luckymuniza/RC_light_control_MFC-01/HW_MFC01/pinout.txt

  J5  J6  J4  J3  J1   J2 
1 3V3 3V3 3V3 KJ4 SPI+ GND
2 SPI SPI 5V  KJ5 SPI- +5V
3 SML SPI SML KJ6 SML+ SBUS 
4 SMR SML SMR KJ7 SML-
5 ZAD SMR MAJ     SMR+
6 BOC ZAD PSV     SMR-
7 MAJ ZAD MAJs    ZAD+
8     SPZ         ZAD-
