luckymuniza/RC_light_control_MFC-01/HW_MFC01/HW_MFC01.kicad_pcb

## KiCad design HW_MFC01/HW_MFC01.kicad_pcb (2026-08-25)

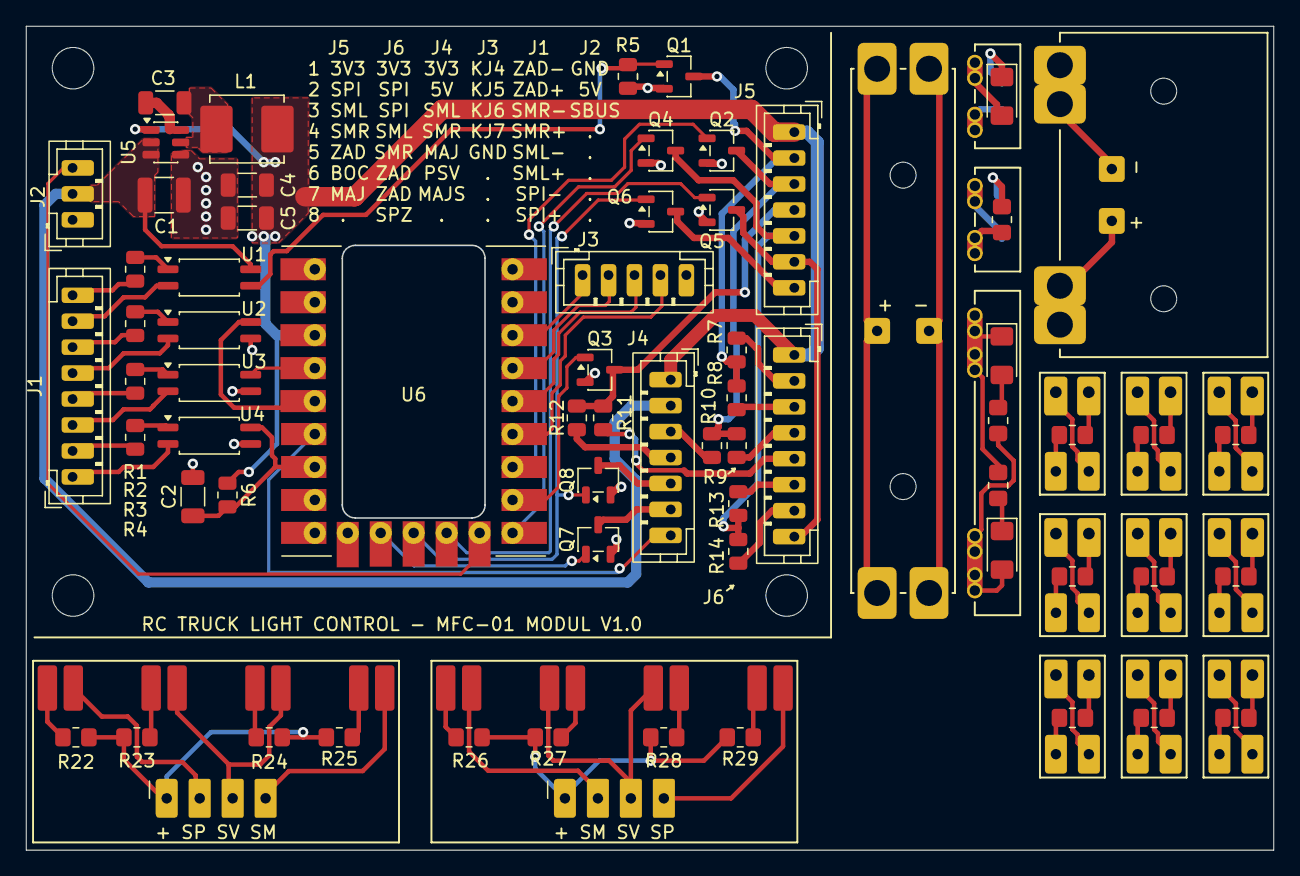
[picture p1: board HW_MFC01.kicad_pcb from above]

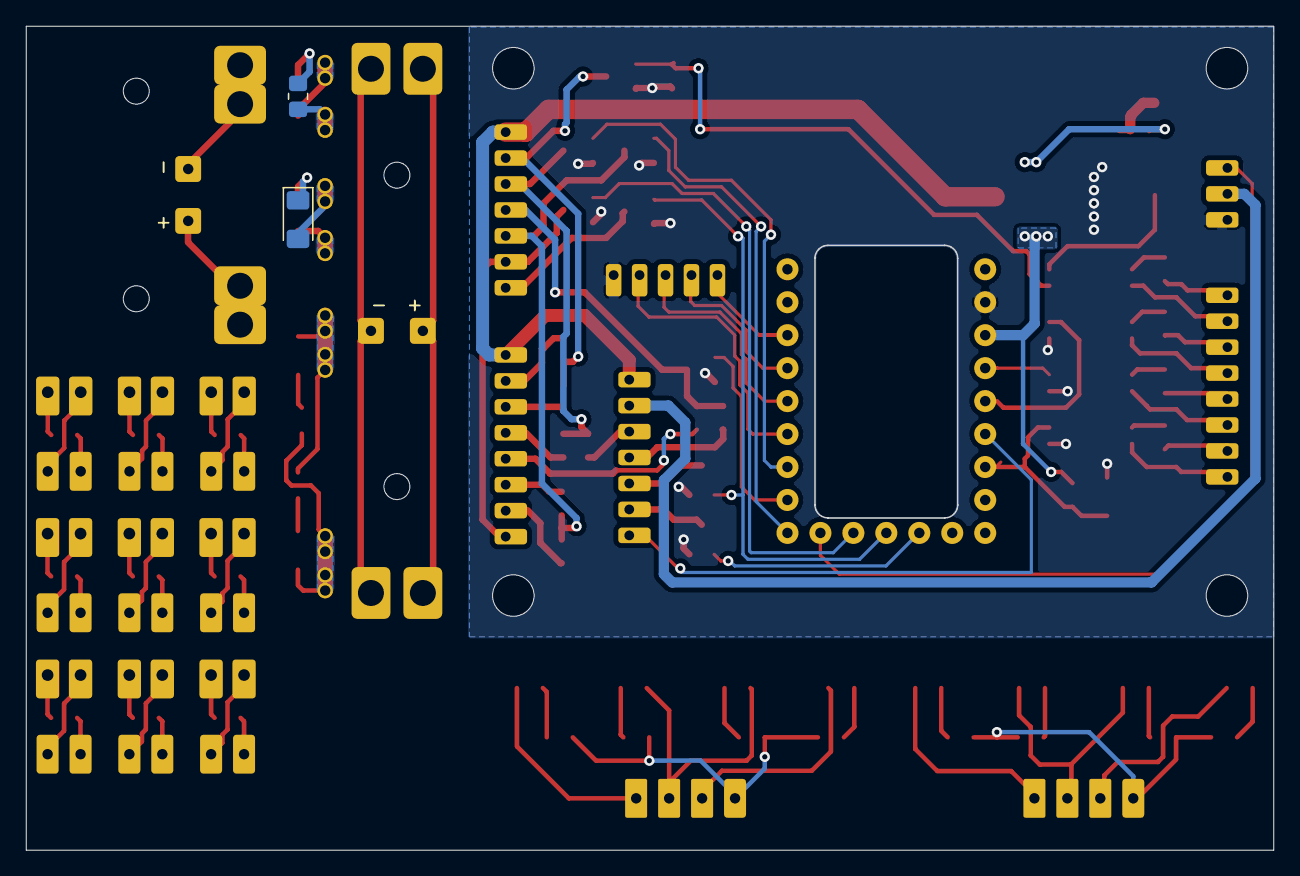
[picture p2: board HW_MFC01.kicad_pcb from below]

Board: 2 copper layers, 96.1 x 63.5 mm, 96 parts (2 on the bottom side), 88 nets.

Parts:
C1: 10u/50V; C_1210_3225Metric
C2, C3: 100n; C_1206_3216Metric
C4, C5: 22u/16V; C_1206_3216Metric
D1, D2, D3, D4: LED; LED_1206_3216Metric_Pad1.42x1.75mm_HandSolder
D5, D5#2, D5#3, D6, D6#2, D6#3, D7, D7#2, D7#3: LED; LED_D3.0mm_mod
H1, H2, H3, H4: MountingHole; MountingHole_3.2mm_M3
J1, J6: Conn_01x08; JST_PH_B8B-PH-K_1x08_P2.00mm_Vertical_Bigpads
J2: JST_PH_B3B-PH-K_1x03_P2.00mm_Vertical_Bigpads
J3: Conn_01x05; JST_PH_B5B-PH-K_1x05_P2.00mm_Vertical_Bigpads
J4, J5: Conn_01x07; JST_PH_B7B-PH-K_1x07_P2.00mm_Vertical_Bigpads
J7: Conn_01x06_Pin; REAR_SPZ1
J8, J9: Conn_01x02_Pin; REAR_SPZ2
J10: Conn_01x04_Pin; REAR2_SPZ1
J11: Conn_01x02_Pin; REAR2_SPZ2
J12, J12#2, J12#3, J13, J13#2, J13#3, J14, J14#2, J14#3: Conn_01x02_Pin; PinSocket_1x02_P2.54mm_modpads
J15, J18: Conn_01x08; rearlight_PCB
J19, J20: Conn_01x04_Pin; PinSocket_1x04_P2.54mm_modpads
L1: 6.8uH; L_Panasonic_PCC-M0530M
Q1, Q2, Q3, Q4, Q5, Q6, Q7, Q8: IRLML0030; SOT-23-3
R1, R2, R3, R4, R5, R6, R7, R8, R9, R10, R11, R12, R13, R14: 10k; R_0805_2012Metric
R15, R16, R17, R18, R19, R19#2, R19#3, R20, R20#2, R20#3, R21, R21#2, R21#3, R22, R23, R24, R25, R26, R27, R28, R29: R; R_0805_2012Metric_Pad1.20x1.40mm_HandSolder
U1, U2, U3, U4: EL3H7; SOP-4_4.4x2.6mm_P1.27mm
U5: AP63203WU; TSOT-23-6
U6: RP2040-Zero; RP2040 Zero undercutted

Connections:
+3.3V: C4.1, C5.1, J4.1, J5.1, J6.1, L1.2, R6.1, U5.1 (FB), U6.3 (3V3)
+5V: C1.1, J2.2, J4.2, U1.4, U5.2 (EN), U5.3 (IN)
/BEACON F: J4.5, Q8.3 (D)
/BEACON_OUT: Q6.1 (G), Q8.1 (G), U6.21 (GP11)
/FRONT_BEACON_PWM: J4.7, U6.6 (GP27)
/HEAD LIGHTS: J4.6, Q7.3 (D)
/HEAD_LIGHTS: Q7.1 (G), U6.20 (GP12)
/J4: J3.1, U6.12 (GP2)
/J5: J3.2, U6.13 (GP3)
/J6: J3.3, U6.14 (GP4)
/J7: J3.4, U6.15 (GP5)
/REAR L: J6.6, R13.1
/REAR R: J6.7, R14.1
/REAR+: J1.2, R4.1
/REAR-: J1.1, U4.2
/REAR_LIGHT_IN: C2.1, R6.2, U4.4, U6.7 (GP26)
/REAR_PWM_OUT: Q4.1 (G), U6.18 (GP8)
/REV+: J1.8, R1.1
/REV-: J1.7, U1.2
/REVERSE L: J6.2, R7.1
/REVERSE R: J6.3, R8.1
/REVERSE_LIGHTS_IN: Q1.1 (G), R5.2, U1.3
/SBUS_IN: J2.3, U6.23 (GP9)
/SIDE_LIGHTS: Q5.1 (G), U6.22 (GP10)
/TRA BEACON: J5.7, Q6.3 (D)
/TRA REAR: J5.5, Q4.3 (D), R13.2, R14.2
/TRA REVERSE: J5.2, Q1.3 (D), R7.2, R8.2
/TRA SIDE LIGHTS/SPZ: J5.6, J6.8, Q5.3 (D)
/TRA TURN L: J5.3, Q2.3 (D), R9.2, R10.2
/TRA TURN R: J5.4, Q3.3 (D), R11.2, R12.2
/TURN F L: J4.3, R10.1
/TURN F R: J4.4, R12.1
/TURN L: J6.4, R9.1
/TURN R: J6.5, R11.1
/TURNL+: J1.6, R2.1
/TURNL-: J1.5, U2.2
/TURNR+: J1.4, R3.1
/TURNR-: J1.3, U3.2
/TURN_L_IN: U2.4, U6.5 (GP28)
/TURN_L_PWM_OUT: Q2.1 (G), U6.16 (GP6)
/TURN_R_IN: U3.4, U6.4 (GP29)
/TURN_R_PWM_OUT: Q3.1 (G), U6.17 (GP7)
GND: C1.2, C2.2, C4.2, C5.2, J2.1, J3.5, Q1.2 (S), Q2.2 (S), Q3.2 (S), Q4.2 (S), Q5.2 (S), Q6.2 (S), Q7.2 (S), Q8.2 (S), R5.1, U2.3, U3.3, U4.3, U5.4 (GND), U6.2 (GND)
unnamed: D1.2 (A), J8.1
unnamed: D1.1 (K), R15.2
unnamed: D2.2 (A), J9.1
unnamed: D2.1 (K), R16.2
unnamed: D3.2 (A), R17.2
unnamed: D3.1 (K), J11.1, R18.1
unnamed: D4.2 (A), J11.2, R17.1
unnamed: D4.1 (K), R18.2
unnamed: D5.2 (A), D5#2.2 (A), D5#3.2 (A), J12.1, J12#2.1, J12#3.1
unnamed: D5.1 (K), D5#2.1 (K), D5#3.1 (K), R19.2, R19#2.2, R19#3.2
unnamed: D6.2 (A), D6#2.2 (A), D6#3.2 (A), J13.1, J13#2.1, J13#3.1
unnamed: D6.1 (K), D6#2.1 (K), D6#3.1 (K), R20.2, R20#2.2, R20#3.2
unnamed: D7.2 (A), D7#2.2 (A), D7#3.2 (A), J14.1, J14#2.1, J14#3.1
unnamed: D7.1 (K), D7#2.1 (K), D7#3.1 (K), R21.2, R21#2.2, R21#3.2
unnamed: J7.1, J7.3, J7.5
unnamed: J7.2, J7.4, J7.6
unnamed: J8.2, R15.1
unnamed: J9.2, R16.1
unnamed: J10.1, J10.3
unnamed: J10.2, J10.4
unnamed: J12.2, J12#2.2, J12#3.2, R19.1, R19#2.1, R19#3.1
unnamed: J13.2, J13#2.2, J13#3.2, R20.1, R20#2.1, R20#3.1
unnamed: J14.2, J14#2.2, J14#3.2, R21.1, R21#2.1, R21#3.1
unnamed: J15.1, R22.1
unnamed: J15.2, J19.2
unnamed: J15.3, R23.1
unnamed: J15.4, J15.6, J19.3
unnamed: J15.5, R24.1
unnamed: J15.7, R25.1
unnamed: J15.8, J19.4
unnamed: J18.1, R26.1
unnamed: J18.2, J20.2
unnamed: J18.3, J18.5, J20.3
unnamed: J18.4, R27.1
unnamed: J18.6, R28.1
unnamed: J18.7, R29.1
unnamed: J18.8, J20.4
unnamed: J19.1, R22.2, R23.2, R24.2, R25.2
unnamed: J20.1, R26.2, R27.2, R28.2, R29.2
unnamed: R1.2, U1.1
unnamed: R2.2, U2.1
unnamed: R3.2, U3.1
unnamed: R4.2, U4.1
unnamed: C3.2, U5.6 (BST)
unnamed: C3.1, L1.1, U5.5 (SW)
