luckymuniza/RC_light_control_MFC-01/FW/beacon.h

//
// Created by all on 2. 9. 2026.
//

#ifndef RC_LIGHT_CONTROL_MFC_01_BEACON_H
#define RC_LIGHT_CONTROL_MFC_01_BEACON_H

void beacon_init(void);
void beacon_service(void);

#endif //RC_LIGHT_CONTROL_MFC_01_BEACON_H
