luckymuniza/RC_light_control_MFC-01/FW/lights.h

//
// Created by all on 16. 12. 2025.
//

#ifndef REAR_LIGHT_H
#define REAR_LIGHT_H

void lights_init(void);
void light_service(void);
void rear_light_on (void);
void rear_light_off (void);

#endif //REAR_LIGHT_H
